ohararp/ESP32-FlipDotBinaryClock/PCB/FlipDotBinF_Panel-Netlist.TXT

ISIS SCHEMATIC DESCRIPTION FORMAT 8.0
=====================================
Design:   FlipDotBinF_Panel.pdsprj
Doc. no.: <NONE>
Revision: <NONE>
Author:   <NONE>
Created:  4/10/2016
Modified: 12/19/2025

*PROPERTIES,0    

*MODELDEFS,0    

*PARTLIST,190  
C1,"SMT ",SMT,EID=5,PACKAGE=0603
C2,"SMT ",SMT,EID=6,PACKAGE=0603
C3,SMT,AP2204-5,EID=30,PACKAGE=0603
C4,"SMT ","10 uF",EID=31,PACKAGE=1206
C5,UWT1E471MNL1GS,"470 uF 25V",BOMLINKS="CODE=http%3A%2F%2Fwww.digikey.com%2Fproduct-detail%2Fen%2Fnichicon%2FUWT1E471MNL1GS%2F493-2194-1-ND%2F590169,",CODE=647-UWT1E471MNL1S,COST=0.253,EID=F,PACKAGE=CAPAE1030X1020,SUPPLIER=Digikey
C6,UWT1E471MNL1GS,"470 uF 25V",BOMLINKS="CODE=http%3A%2F%2Fwww.digikey.com%2Fproduct-detail%2Fen%2Fnichicon%2FUWT1E471MNL1GS%2F493-2194-1-ND%2F590169,",CODE=647-UWT1E471MNL1S,COST=0.253,EID=19,PACKAGE=CAPAE1030X1020,SUPPLIER=Digikey
C7,UWT1E471MNL1GS,"470 uF 25V",BOMLINKS="CODE=http%3A%2F%2Fwww.digikey.com%2Fproduct-detail%2Fen%2Fnichicon%2FUWT1E471MNL1GS%2F493-2194-1-ND%2F590169,",CODE=647-UWT1E471MNL1S,COST=0.253,EID=23,PACKAGE=CAPAE1030X1020,SUPPLIER=Digikey
C8,UWT1E471MNL1GS,"470 uF 25V",BOMLINKS="CODE=http%3A%2F%2Fwww.digikey.com%2Fproduct-detail%2Fen%2Fnichicon%2FUWT1E471MNL1GS%2F493-2194-1-ND%2F590169,",CODE=647-UWT1E471MNL1S,COST=0.253,EID=2D,PACKAGE=CAPAE1030X1020,SUPPLIER=Digikey
C9,"SMT ",SMT,EID=34,PACKAGE=0603
C10,"SMT ",SMT,EID=35,PACKAGE=0603
C11,SMT,AP2204-5,EID=5F,PACKAGE=0603
C12,"SMT ","10 uF",EID=60,PACKAGE=1206
C13,UWT1E471MNL1GS,"470 uF 25V",BOMLINKS="CODE=http%3A%2F%2Fwww.digikey.com%2Fproduct-detail%2Fen%2Fnichicon%2FUWT1E471MNL1GS%2F493-2194-1-ND%2F590169,",CODE=647-UWT1E471MNL1S,COST=0.253,EID=3E,PACKAGE=CAPAE1030X1020,SUPPLIER=Digikey
C14,UWT1E471MNL1GS,"470 uF 25V",BOMLINKS="CODE=http%3A%2F%2Fwww.digikey.com%2Fproduct-detail%2Fen%2Fnichicon%2FUWT1E471MNL1GS%2F493-2194-1-ND%2F590169,",CODE=647-UWT1E471MNL1S,COST=0.253,EID=48,PACKAGE=CAPAE1030X1020,SUPPLIER=Digikey
C15,UWT1E471MNL1GS,"470 uF 25V",BOMLINKS="CODE=http%3A%2F%2Fwww.digikey.com%2Fproduct-detail%2Fen%2Fnichicon%2FUWT1E471MNL1GS%2F493-2194-1-ND%2F590169,",CODE=647-UWT1E471MNL1S,COST=0.253,EID=52,PACKAGE=CAPAE1030X1020,SUPPLIER=Digikey
C16,UWT1E471MNL1GS,"470 uF 25V",BOMLINKS="CODE=http%3A%2F%2Fwww.digikey.com%2Fproduct-detail%2Fen%2Fnichicon%2FUWT1E471MNL1GS%2F493-2194-1-ND%2F590169,",CODE=647-UWT1E471MNL1S,COST=0.253,EID=5C,PACKAGE=CAPAE1030X1020,SUPPLIER=Digikey
C17,"SMT ",SMT,EID=63,PACKAGE=0603
C18,"SMT ",SMT,EID=64,PACKAGE=0603
C19,SMT,AP2204-5,EID=8E,PACKAGE=0603
C20,"SMT ","10 uF",EID=8F,PACKAGE=1206
C21,UWT1E471MNL1GS,"470 uF 25V",BOMLINKS="CODE=http%3A%2F%2Fwww.digikey.com%2Fproduct-detail%2Fen%2Fnichicon%2FUWT1E471MNL1GS%2F493-2194-1-ND%2F590169,",CODE=647-UWT1E471MNL1S,COST=0.253,EID=6D,PACKAGE=CAPAE1030X1020,SUPPLIER=Digikey
C22,UWT1E471MNL1GS,"470 uF 25V",BOMLINKS="CODE=http%3A%2F%2Fwww.digikey.com%2Fproduct-detail%2Fen%2Fnichicon%2FUWT1E471MNL1GS%2F493-2194-1-ND%2F590169,",CODE=647-UWT1E471MNL1S,COST=0.253,EID=77,PACKAGE=CAPAE1030X1020,SUPPLIER=Digikey
C23,UWT1E471MNL1GS,"470 uF 25V",BOMLINKS="CODE=http%3A%2F%2Fwww.digikey.com%2Fproduct-detail%2Fen%2Fnichicon%2FUWT1E471MNL1GS%2F493-2194-1-ND%2F590169,",CODE=647-UWT1E471MNL1S,COST=0.253,EID=81,PACKAGE=CAPAE1030X1020,SUPPLIER=Digikey
C24,UWT1E471MNL1GS,"470 uF 25V",BOMLINKS="CODE=http%3A%2F%2Fwww.digikey.com%2Fproduct-detail%2Fen%2Fnichicon%2FUWT1E471MNL1GS%2F493-2194-1-ND%2F590169,",CODE=647-UWT1E471MNL1S,COST=0.253,EID=8B,PACKAGE=CAPAE1030X1020,SUPPLIER=Digikey
C25,"SMT ",SMT,EID=92,PACKAGE=0603
C26,"SMT ",SMT,EID=93,PACKAGE=0603
C27,SMT,AP2204-5,EID=BD,PACKAGE=0603
C28,"SMT ","10 uF",EID=BE,PACKAGE=1206
C29,UWT1E471MNL1GS,"470 uF 25V",BOMLINKS="CODE=http%3A%2F%2Fwww.digikey.com%2Fproduct-detail%2Fen%2Fnichicon%2FUWT1E471MNL1GS%2F493-2194-1-ND%2F590169,",CODE=647-UWT1E471MNL1S,COST=0.253,EID=9C,PACKAGE=CAPAE1030X1020,SUPPLIER=Digikey
C30,UWT1E471MNL1GS,"470 uF 25V",BOMLINKS="CODE=http%3A%2F%2Fwww.digikey.com%2Fproduct-detail%2Fen%2Fnichicon%2FUWT1E471MNL1GS%2F493-2194-1-ND%2F590169,",CODE=647-UWT1E471MNL1S,COST=0.253,EID=A6,PACKAGE=CAPAE1030X1020,SUPPLIER=Digikey
C31,UWT1E471MNL1GS,"470 uF 25V",BOMLINKS="CODE=http%3A%2F%2Fwww.digikey.com%2Fproduct-detail%2Fen%2Fnichicon%2FUWT1E471MNL1GS%2F493-2194-1-ND%2F590169,",CODE=647-UWT1E471MNL1S,COST=0.253,EID=B0,PACKAGE=CAPAE1030X1020,SUPPLIER=Digikey
C32,UWT1E471MNL1GS,"470 uF 25V",BOMLINKS="CODE=http%3A%2F%2Fwww.digikey.com%2Fproduct-detail%2Fen%2Fnichicon%2FUWT1E471MNL1GS%2F493-2194-1-ND%2F590169,",CODE=647-UWT1E471MNL1S,COST=0.253,EID=BA,PACKAGE=CAPAE1030X1020,SUPPLIER=Digikey
D1,BAV74,BAV70LT1G,EID=9,PACKAGE=SOT23,PINSWAP="2,3",SPICELIB=ZETEX,SPICEMODEL=BAV74
D2,BAV74,BAV70LT1G,EID=12,PACKAGE=SOT23,PINSWAP="2,3",SPICELIB=ZETEX,SPICEMODEL=BAV74
D3,BAV74,BAV70LT1G,EID=1D,PACKAGE=SOT23,PINSWAP="2,3",SPICELIB=ZETEX,SPICEMODEL=BAV74
D4,BAV74,BAV70LT1G,EID=27,PACKAGE=SOT23,PINSWAP="2,3",SPICELIB=ZETEX,SPICEMODEL=BAV74
D5,BAV74,BAV70LT1G,EID=38,PACKAGE=SOT23,PINSWAP="2,3",SPICELIB=ZETEX,SPICEMODEL=BAV74
D6,BAV74,BAV70LT1G,EID=41,PACKAGE=SOT23,PINSWAP="2,3",SPICELIB=ZETEX,SPICEMODEL=BAV74
D7,BAV74,BAV70LT1G,EID=4C,PACKAGE=SOT23,PINSWAP="2,3",SPICELIB=ZETEX,SPICEMODEL=BAV74
D8,BAV74,BAV70LT1G,EID=56,PACKAGE=SOT23,PINSWAP="2,3",SPICELIB=ZETEX,SPICEMODEL=BAV74
D9,BAV74,BAV70LT1G,EID=67,PACKAGE=SOT23,PINSWAP="2,3",SPICELIB=ZETEX,SPICEMODEL=BAV74
D10,BAV74,BAV70LT1G,EID=70,PACKAGE=SOT23,PINSWAP="2,3",SPICELIB=ZETEX,SPICEMODEL=BAV74
D11,BAV74,BAV70LT1G,EID=7B,PACKAGE=SOT23,PINSWAP="2,3",SPICELIB=ZETEX,SPICEMODEL=BAV74
D12,BAV74,BAV70LT1G,EID=85,PACKAGE=SOT23,PINSWAP="2,3",SPICELIB=ZETEX,SPICEMODEL=BAV74
D13,BAV74,BAV70LT1G,EID=96,PACKAGE=SOT23,PINSWAP="2,3",SPICELIB=ZETEX,SPICEMODEL=BAV74
D14,BAV74,BAV70LT1G,EID=9F,PACKAGE=SOT23,PINSWAP="2,3",SPICELIB=ZETEX,SPICEMODEL=BAV74
D15,BAV74,BAV70LT1G,EID=AA,PACKAGE=SOT23,PINSWAP="2,3",SPICELIB=ZETEX,SPICEMODEL=BAV74
D16,BAV74,BAV70LT1G,EID=B4,PACKAGE=SOT23,PINSWAP="2,3",SPICELIB=ZETEX,SPICEMODEL=BAV74
FP1,FLIPDOT-1872R,FLIPDOT-1872R,CODE=1872RFR,EID=A,PACKAGE=FLIPDOT-1872R
FP2,FLIPDOT-1872R,FLIPDOT-1872R,CODE=1872RFR,EID=14,PACKAGE=FLIPDOT-1872R
FP3,FLIPDOT-1872R,FLIPDOT-1872R,CODE=1872RFR,EID=1E,PACKAGE=FLIPDOT-1872R
FP4,FLIPDOT-1872R,FLIPDOT-1872R,CODE=1872RFR,EID=28,PACKAGE=FLIPDOT-1872R
FP5,FLIPDOT-1872R,FLIPDOT-1872R,CODE=1872RFR,EID=39,PACKAGE=FLIPDOT-1872R
FP6,FLIPDOT-1872R,FLIPDOT-1872R,CODE=1872RFR,EID=43,PACKAGE=FLIPDOT-1872R
FP7,FLIPDOT-1872R,FLIPDOT-1872R,CODE=1872RFR,EID=4D,PACKAGE=FLIPDOT-1872R
FP8,FLIPDOT-1872R,FLIPDOT-1872R,CODE=1872RFR,EID=57,PACKAGE=FLIPDOT-1872R
FP9,FLIPDOT-1872R,FLIPDOT-1872R,CODE=1872RFR,EID=68,PACKAGE=FLIPDOT-1872R
FP10,FLIPDOT-1872R,FLIPDOT-1872R,CODE=1872RFR,EID=72,PACKAGE=FLIPDOT-1872R
FP11,FLIPDOT-1872R,FLIPDOT-1872R,CODE=1872RFR,EID=7C,PACKAGE=FLIPDOT-1872R
FP12,FLIPDOT-1872R,FLIPDOT-1872R,CODE=1872RFR,EID=86,PACKAGE=FLIPDOT-1872R
FP13,FLIPDOT-1872R,FLIPDOT-1872R,CODE=1872RFR,EID=97,PACKAGE=FLIPDOT-1872R
FP14,FLIPDOT-1872R,FLIPDOT-1872R,CODE=1872RFR,EID=A1,PACKAGE=FLIPDOT-1872R
FP15,FLIPDOT-1872R,FLIPDOT-1872R,CODE=1872RFR,EID=AB,PACKAGE=FLIPDOT-1872R
FP16,FLIPDOT-1872R,FLIPDOT-1872R,CODE=1872RFR,EID=B5,PACKAGE=FLIPDOT-1872R
G1-DATA IN,GROVE_SER,"GROVE I2C",CODE=1125s-SMT-4P,EID=2,PACKAGE=1125S-SMT-4P-HORZ
G2-PWR,GROVE_SER,"GROVE I2C",CODE=1125s-SMT-4P,EID=3,PACKAGE=1125S-SMT-4P-HORZ
Q1,DMG3402L,DMG3402L,CODE=DMG3402L-7DICT-ND,EID=8,PACKAGE=SOT23-3,SPICEPINS="D,G,S"
Q2,DMG3402L,DMG3402L,CODE=DMG3402L-7DICT-ND,EID=C,PACKAGE=SOT23-3,SPICEPINS="D,G,S"
Q3,DMG6602SVT-2,DMG6602SVT-2,EID=D,PACKAGE=TSOP-6-FIX
Q4,DMG3402L,DMG3402L,CODE=DMG3402L-7DICT-ND,EID=11,PACKAGE=SOT23-3,SPICEPINS="D,G,S"
Q5,DMG3402L,DMG3402L,CODE=DMG3402L-7DICT-ND,EID=16,PACKAGE=SOT23-3,SPICEPINS="D,G,S"
Q6,DMG6602SVT-2,DMG6602SVT-2,EID=17,PACKAGE=TSOP-6-FIX
Q7,DMG3402L,DMG3402L,CODE=DMG3402L-7DICT-ND,EID=1C,PACKAGE=SOT23-3,SPICEPINS="D,G,S"
Q8,DMG3402L,DMG3402L,CODE=DMG3402L-7DICT-ND,EID=20,PACKAGE=SOT23-3,SPICEPINS="D,G,S"
Q9,DMG6602SVT-2,DMG6602SVT-2,EID=21,PACKAGE=TSOP-6-FIX
Q10,DMG3402L,DMG3402L,CODE=DMG3402L-7DICT-ND,EID=26,PACKAGE=SOT23-3,SPICEPINS="D,G,S"
Q11,DMG3402L,DMG3402L,CODE=DMG3402L-7DICT-ND,EID=2A,PACKAGE=SOT23-3,SPICEPINS="D,G,S"
Q12,DMG6602SVT-2,DMG6602SVT-2,EID=2B,PACKAGE=TSOP-6-FIX
Q13,DMG3402L,DMG3402L,CODE=DMG3402L-7DICT-ND,EID=37,PACKAGE=SOT23-3,SPICEPINS="D,G,S"
Q14,DMG3402L,DMG3402L,CODE=DMG3402L-7DICT-ND,EID=3B,PACKAGE=SOT23-3,SPICEPINS="D,G,S"
Q15,DMG6602SVT-2,DMG6602SVT-2,EID=3C,PACKAGE=TSOP-6-FIX
Q16,DMG3402L,DMG3402L,CODE=DMG3402L-7DICT-ND,EID=40,PACKAGE=SOT23-3,SPICEPINS="D,G,S"
Q17,DMG3402L,DMG3402L,CODE=DMG3402L-7DICT-ND,EID=45,PACKAGE=SOT23-3,SPICEPINS="D,G,S"
Q18,DMG6602SVT-2,DMG6602SVT-2,EID=46,PACKAGE=TSOP-6-FIX
Q19,DMG3402L,DMG3402L,CODE=DMG3402L-7DICT-ND,EID=4B,PACKAGE=SOT23-3,SPICEPINS="D,G,S"
Q20,DMG3402L,DMG3402L,CODE=DMG3402L-7DICT-ND,EID=4F,PACKAGE=SOT23-3,SPICEPINS="D,G,S"
Q21,DMG6602SVT-2,DMG6602SVT-2,EID=50,PACKAGE=TSOP-6-FIX
Q22,DMG3402L,DMG3402L,CODE=DMG3402L-7DICT-ND,EID=55,PACKAGE=SOT23-3,SPICEPINS="D,G,S"
Q23,DMG3402L,DMG3402L,CODE=DMG3402L-7DICT-ND,EID=59,PACKAGE=SOT23-3,SPICEPINS="D,G,S"
Q24,DMG6602SVT-2,DMG6602SVT-2,EID=5A,PACKAGE=TSOP-6-FIX
Q25,DMG3402L,DMG3402L,CODE=DMG3402L-7DICT-ND,EID=66,PACKAGE=SOT23-3,SPICEPINS="D,G,S"
Q26,DMG3402L,DMG3402L,CODE=DMG3402L-7DICT-ND,EID=6A,PACKAGE=SOT23-3,SPICEPINS="D,G,S"
Q27,DMG6602SVT-2,DMG6602SVT-2,EID=6B,PACKAGE=TSOP-6-FIX
Q28,DMG3402L,DMG3402L,CODE=DMG3402L-7DICT-ND,EID=6F,PACKAGE=SOT23-3,SPICEPINS="D,G,S"
Q29,DMG3402L,DMG3402L,CODE=DMG3402L-7DICT-ND,EID=74,PACKAGE=SOT23-3,SPICEPINS="D,G,S"
Q30,DMG6602SVT-2,DMG6602SVT-2,EID=75,PACKAGE=TSOP-6-FIX
Q31,DMG3402L,DMG3402L,CODE=DMG3402L-7DICT-ND,EID=7A,PACKAGE=SOT23-3,SPICEPINS="D,G,S"
Q32,DMG3402L,DMG3402L,CODE=DMG3402L-7DICT-ND,EID=7E,PACKAGE=SOT23-3,SPICEPINS="D,G,S"
Q33,DMG6602SVT-2,DMG6602SVT-2,EID=7F,PACKAGE=TSOP-6-FIX
Q34,DMG3402L,DMG3402L,CODE=DMG3402L-7DICT-ND,EID=84,PACKAGE=SOT23-3,SPICEPINS="D,G,S"
Q35,DMG3402L,DMG3402L,CODE=DMG3402L-7DICT-ND,EID=88,PACKAGE=SOT23-3,SPICEPINS="D,G,S"
Q36,DMG6602SVT-2,DMG6602SVT-2,EID=89,PACKAGE=TSOP-6-FIX
Q37,DMG3402L,DMG3402L,CODE=DMG3402L-7DICT-ND,EID=95,PACKAGE=SOT23-3,SPICEPINS="D,G,S"
Q38,DMG3402L,DMG3402L,CODE=DMG3402L-7DICT-ND,EID=99,PACKAGE=SOT23-3,SPICEPINS="D,G,S"
Q39,DMG6602SVT-2,DMG6602SVT-2,EID=9A,PACKAGE=TSOP-6-FIX
Q40,DMG3402L,DMG3402L,CODE=DMG3402L-7DICT-ND,EID=9E,PACKAGE=SOT23-3,SPICEPINS="D,G,S"
Q41,DMG3402L,DMG3402L,CODE=DMG3402L-7DICT-ND,EID=A3,PACKAGE=SOT23-3,SPICEPINS="D,G,S"
Q42,DMG6602SVT-2,DMG6602SVT-2,EID=A4,PACKAGE=TSOP-6-FIX
Q43,DMG3402L,DMG3402L,CODE=DMG3402L-7DICT-ND,EID=A9,PACKAGE=SOT23-3,SPICEPINS="D,G,S"
Q44,DMG3402L,DMG3402L,CODE=DMG3402L-7DICT-ND,EID=AD,PACKAGE=SOT23-3,SPICEPINS="D,G,S"
Q45,DMG6602SVT-2,DMG6602SVT-2,EID=AE,PACKAGE=TSOP-6-FIX
Q46,DMG3402L,DMG3402L,CODE=DMG3402L-7DICT-ND,EID=B3,PACKAGE=SOT23-3,SPICEPINS="D,G,S"
Q47,DMG3402L,DMG3402L,CODE=DMG3402L-7DICT-ND,EID=B7,PACKAGE=SOT23-3,SPICEPINS="D,G,S"
Q48,DMG6602SVT-2,DMG6602SVT-2,EID=B8,PACKAGE=TSOP-6-FIX
R1,RES,22k,EID=7,PACKAGE=0603,PRIMTYPE=RESISTOR
R2,RES,22k,EID=B,PACKAGE=0603,PRIMTYPE=RESISTOR
R3,RES,22k,EID=E,PACKAGE=0603,PRIMTYPE=RESISTOR
R4,RES,22k,EID=13,PACKAGE=0603,PRIMTYPE=RESISTOR
R5,RES,22k,EID=10,PACKAGE=0603,PRIMTYPE=RESISTOR
R6,RES,22k,EID=15,PACKAGE=0603,PRIMTYPE=RESISTOR
R7,RES,22k,EID=18,PACKAGE=0603,PRIMTYPE=RESISTOR
R8,RES,22k,EID=1A,PACKAGE=0603,PRIMTYPE=RESISTOR
R9,RES,22k,EID=1B,PACKAGE=0603,PRIMTYPE=RESISTOR
R10,RES,22k,EID=1F,PACKAGE=0603,PRIMTYPE=RESISTOR
R11,RES,22k,EID=22,PACKAGE=0603,PRIMTYPE=RESISTOR
R12,RES,22k,EID=24,PACKAGE=0603,PRIMTYPE=RESISTOR
R13,RES,22k,EID=25,PACKAGE=0603,PRIMTYPE=RESISTOR
R14,RES,22k,EID=29,PACKAGE=0603,PRIMTYPE=RESISTOR
R15,RES,22k,EID=2C,PACKAGE=0603,PRIMTYPE=RESISTOR
R16,RES,22k,EID=2E,PACKAGE=0603,PRIMTYPE=RESISTOR
R17,RES,22k,EID=36,PACKAGE=0603,PRIMTYPE=RESISTOR
R18,RES,22k,EID=3A,PACKAGE=0603,PRIMTYPE=RESISTOR
R19,RES,22k,EID=3D,PACKAGE=0603,PRIMTYPE=RESISTOR
R20,RES,22k,EID=42,PACKAGE=0603,PRIMTYPE=RESISTOR
R21,RES,22k,EID=3F,PACKAGE=0603,PRIMTYPE=RESISTOR
R22,RES,22k,EID=44,PACKAGE=0603,PRIMTYPE=RESISTOR
R23,RES,22k,EID=47,PACKAGE=0603,PRIMTYPE=RESISTOR
R24,RES,22k,EID=49,PACKAGE=0603,PRIMTYPE=RESISTOR
R25,RES,22k,EID=4A,PACKAGE=0603,PRIMTYPE=RESISTOR
R26,RES,22k,EID=4E,PACKAGE=0603,PRIMTYPE=RESISTOR
R27,RES,22k,EID=51,PACKAGE=0603,PRIMTYPE=RESISTOR
R28,RES,22k,EID=53,PACKAGE=0603,PRIMTYPE=RESISTOR
R29,RES,22k,EID=54,PACKAGE=0603,PRIMTYPE=RESISTOR
R30,RES,22k,EID=58,PACKAGE=0603,PRIMTYPE=RESISTOR
R31,RES,22k,EID=5B,PACKAGE=0603,PRIMTYPE=RESISTOR
R32,RES,22k,EID=5D,PACKAGE=0603,PRIMTYPE=RESISTOR
R33,RES,22k,EID=65,PACKAGE=0603,PRIMTYPE=RESISTOR
R34,RES,22k,EID=69,PACKAGE=0603,PRIMTYPE=RESISTOR
R35,RES,22k,EID=6C,PACKAGE=0603,PRIMTYPE=RESISTOR
R36,RES,22k,EID=71,PACKAGE=0603,PRIMTYPE=RESISTOR
R37,RES,22k,EID=6E,PACKAGE=0603,PRIMTYPE=RESISTOR
R38,RES,22k,EID=73,PACKAGE=0603,PRIMTYPE=RESISTOR
R39,RES,22k,EID=76,PACKAGE=0603,PRIMTYPE=RESISTOR
R40,RES,22k,EID=78,PACKAGE=0603,PRIMTYPE=RESISTOR
R41,RES,22k,EID=79,PACKAGE=0603,PRIMTYPE=RESISTOR
R42,RES,22k,EID=7D,PACKAGE=0603,PRIMTYPE=RESISTOR
R43,RES,22k,EID=80,PACKAGE=0603,PRIMTYPE=RESISTOR
R44,RES,22k,EID=82,PACKAGE=0603,PRIMTYPE=RESISTOR
R45,RES,22k,EID=83,PACKAGE=0603,PRIMTYPE=RESISTOR
R46,RES,22k,EID=87,PACKAGE=0603,PRIMTYPE=RESISTOR
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
R15,PS,1
Q12,PS,5
Q11,PS,3
R14,PS,1
Q10,PS,3
R13,PS,1
C8,PS,2
R11,PS,1
Q9,PS,5
Q8,PS,3
R10,PS,1
Q7,PS,3
R9,PS,1
C7,PS,2
R7,PS,1
Q6,PS,5
Q5,PS,3
R6,PS,1
Q4,PS,3
R5,PS,1
C6,PS,2
R3,PS,1
Q3,PS,5
Q2,PS,3
R2,PS,1
Q1,PS,3
R1,PS,1
C5,PS,2
C2,PS,2
C1,PS,2
U2,PP,8
U1,PP,8
G2-PWR,PP,4
G1-DATA IN,PP,4

HV,62,CLASS=POWER
HV,PR
U12,PS,1
U12,PS,3
C28,PS,2
Q48,PS,2
R64,PS,2
C32,PS,1
Q45,PS,2
R60,PS,2
C31,PS,1
Q42,PS,2
R56,PS,2
C30,PS,1
Q39,PS,2
R52,PS,2
C29,PS,1
U9,PS,1
U9,PS,3
C20,PS,2
Q36,PS,2
R48,PS,2
C24,PS,1
Q33,PS,2
R44,PS,2
C23,PS,1
Q30,PS,2
R40,PS,2
C22,PS,1
Q27,PS,2
R36,PS,2
C21,PS,1
U6,PS,1
U6,PS,3
C12,PS,2
Q24,PS,2
R32,PS,2
C16,PS,1
Q21,PS,2
R28,PS,2
C15,PS,1
Q18,PS,2
R24,PS,2
C14,PS,1
Q15,PS,2
R20,PS,2
C13,PS,1
U3,PS,1
U3,PS,3
C4,PS,2
Q12,PS,2
R16,PS,2
C8,PS,1
Q9,PS,2
R12,PS,2
C7,PS,1
Q6,PS,2
R8,PS,2
C6,PS,1
Q3,PS,2
R4,PS,2
C5,PS,1
G2-PWR,PP,3
