ohararp/ESP32-FlipDotBinaryClock/PCB/FlipDotMasterC-netlist.TXT

ISIS SCHEMATIC DESCRIPTION FORMAT 8.0
=====================================
Design:   FlipDotMasterC.pdsprj
Doc. no.: <NONE>
Revision: <NONE>
Author:   <NONE>
Created:  5/20/2017
Modified: 1/6/2018

*PROPERTIES,0    

*MODELDEFS,0    

*PARTLIST,32   
B1-RESET,PTS810,PTS810,CODE=CKN10503TR-ND,COST=0.58,EID=36,PACKAGE=PTS810,R(0)=100M,R(1)=100m,STATE=0,SUPPLIER=Digikey,TSWITCH=1m
B2-HRS,PTS810,PTS810,CODE=CKN10503TR-ND,COST=0.58,EID=9,PACKAGE=PTS810,R(0)=100M,R(1)=100m,STATE=0,SUPPLIER=Digikey,TSWITCH=1m
B3-MINS,PTS810,PTS810,CODE=CKN10503TR-ND,COST=0.58,EID=C,PACKAGE=PTS810,R(0)=100M,R(1)=100m,STATE=0,SUPPLIER=Digikey,TSWITCH=1m
BAT1,S8411-45R,3.3V,BOMLINKS="CODE=http%3A%2F%2Fwww.digikey.com%2Fproduct-detail%2Fen%2FS8411-45R%2F952-1745-1-ND%2F3131073,",CODE="952-1745-1-ND ",COST=1.08,EID=4,PACKAGE=S8411-45R,SUPPLIER=Digikey
BST1,XL6009BRD2,XL6009BRD2,COST=2.86,EID=10,PACKAGE=XL6009BRD2,SUPPLIER=Alibaba
C1,"SMT ","10 uF",EID=F,PACKAGE=1206
C2,"SMT ","10 uF",EID=E,PACKAGE=0603
C3,"SMT ",0.1UF,EID=3C,PACKAGE=0603
C4,"SMT ",0.1UF,EID=3B,PACKAGE=0603
C5,"SMT ",0.1UF,EID=23,PACKAGE=0603
C6,"SMT ",0.1UF,EID=7,PACKAGE=0603
C7,UWT1E471MNL1GS,"470 uF 25V",BOMLINKS="CODE=http%3A%2F%2Fwww.digikey.com%2Fproduct-detail%2Fen%2Fnichicon%2FUWT1E471MNL1GS%2F493-2194-1-ND%2F590169,",CODE=647-UWT1E471MNL1S,COST=0.253,EID=22,PACKAGE=CAPAE1030X1020,SUPPLIER=Digikey
C8,UWT1E471MNL1GS,"470 uF 25V",BOMLINKS="CODE=http%3A%2F%2Fwww.digikey.com%2Fproduct-detail%2Fen%2Fnichicon%2FUWT1E471MNL1GS%2F493-2194-1-ND%2F590169,",CODE=647-UWT1E471MNL1S,COST=0.253,EID=24,PACKAGE=CAPAE1030X1020,SUPPLIER=Digikey
C9,UWT1E471MNL1GS,"470 uF 25V",BOMLINKS="CODE=http%3A%2F%2Fwww.digikey.com%2Fproduct-detail%2Fen%2Fnichicon%2FUWT1E471MNL1GS%2F493-2194-1-ND%2F590169,",CODE=647-UWT1E471MNL1S,COST=0.253,EID=25,PACKAGE=CAPAE1030X1020,SUPPLIER=Digikey
C10,UWT1E471MNL1GS,"470 uF 25V",BOMLINKS="CODE=http%3A%2F%2Fwww.digikey.com%2Fproduct-detail%2Fen%2Fnichicon%2FUWT1E471MNL1GS%2F493-2194-1-ND%2F590169,",CODE=647-UWT1E471MNL1S,COST=0.253,EID=26,PACKAGE=CAPAE1030X1020,SUPPLIER=Digikey
D4,LED,,BV=4V,CJO=10p,EID=2A,IS=1E-38,N=1,PACKAGE=0603-LED,RS=3
G1-DATA OUT,GROVE_SER,"GROVE SER",CODE=1125s-SMT-4P,EID=A,PACKAGE=1125S-SMT-4P-HORZ
G2-HV OUT,GROVE_SER,"GROVE PWR",CODE=1125s-SMT-4P,EID=16,PACKAGE=1125S-SMT-4P-HORZ
J1-5V,PJ-102A,PJ-102A,BOMLINKS="CODE=http%3A%2F%2Fwww.digikey.com%2Fproduct-detail%2Fen%2FPJ-102A%2FCP-102A-ND%2F275425,",CODE=CP-102A-ND,COST=1.0,EID=1,PACKAGE=PJ-102AB,SUPPLIER=Digikey
J2,CONN-DIL6,CONN-DIL6,EID=20,PACKAGE=CONN-DIL6
J6-FTDI,FTDI_CABLE,FTDI_CABLE,CODE=768-1015-ND,COST=0.074,EID=3A,LINK=http://www.digikey.com/product-detail/en/TTL-232R-3V3/768-1015-ND/1836393,PACKAGE="FTDI CABLE",PARTID=HWS2382,SUPPLIER=Digikey
R1,RES,4k7,BOMLINKS="CODE=http%3A%2F%2Fwww.digikey.com%2Fproduct-detail%2Fen%2FRC1206JR-074K7L%2F311-4.7KERCT-ND%2F732242,",CODE=311-4.7KERTR-ND,COST=0.00289,EID=5,PACKAGE=0603,PRIMTYPE=RESISTOR,SUPPLIER=Digikey
R2,RES,4k7,BOMLINKS="CODE=http%3A%2F%2Fwww.digikey.com%2Fproduct-detail%2Fen%2FRC1206JR-074K7L%2F311-4.7KERCT-ND%2F732242,",CODE=311-4.7KERTR-ND,COST=0.00289,EID=6,PACKAGE=0603,PRIMTYPE=RESISTOR,SUPPLIER=Digikey
R3,RES,4k7,BOMLINKS="CODE=http%3A%2F%2Fwww.digikey.com%2Fproduct-detail%2Fen%2FRC1206JR-074K7L%2F311-4.7KERCT-ND%2F732242,",CODE=311-4.7KERTR-ND,COST=0.00289,EID=18,PACKAGE=0603,PRIMTYPE=RESISTOR,SUPPLIER=Digikey
R4,MINRES10K,10k,EID=1E,PACKAGE=0603,PRIMTYPE=RESISTOR
R5,MINRES10K,10k,EID=8,PACKAGE=0603,PRIMTYPE=RESISTOR
R6,MINRES10K,10k,EID=B,PACKAGE=0603,PRIMTYPE=RESISTOR
R9,MINRES330R,330R,CODE=311-330GTR-ND,EID=29,PACKAGE=0603,PRIMTYPE=RESISTOR,SUPPLIER=Digikey
U1,AP2204-33,AP2204-33,BOMLINKS="CODE=http%3A%2F%2Fwww.digikey.com%2Fproduct-detail%2Fen%2Fdiodes-incorporated%2FAP2204K-3.3TRG1%2FAP2204K-3.3TRG1DICT-ND%2F4505288,",CODE=AP2204K-3.3TRG1,COST=0.45,EID=D,PACKAGE=SOT23-5,SUPPLIER=Digikey
U3,ATMEGA328P_32PIN,ATMEGA328P_32PIN,BOMLINKS="CODE=http%3A%2F%2Fwww.digikey.com%2Fproduct-search%2Fen%3Fkeywords%3DATMEGA328P-AURCT-ND,",BOOTRST=1,BOOTSZ=0,CKOUT=1,CKSEL=2,CLKDIV8=0,CODE=ATMEGA328P-AURCT-ND,CODEGEN=AVRASM2,COST=3.7,DISASM_BIN=0,EID=39,ITFMOD=AVR,MODDATA="1024,255",MODDLL=AVR2.DLL,PACKAGE=QFP80P900X900X120-32,RSTDISBL=1,SUPPLIER=Digikey,SUT=2,TRACE_DEFAULT=1,WDTON=1
U4,DS3231,DS3231,BOMLINKS="CODE=http%3A%2F%2Fwww.digikey.com%2Fproduct-detail%2Fen%2FDS3231S%2523%2FDS3231S%2523-ND%2F1197574,",CODE=DS3231S#-ND,COST=8.35,EID=17,PACKAGE=SO16W
X1,CSTC08M0V53-R0,CSTCE8M00G55Z-R0,BOMLINKS="CODE=http%3A%2F%2Fwww.digikey.com%2Fproduct-detail%2Fen%2Fmurata-electronics-north-america%2FCSTCE8M00G55Z-R0%2F490-1219-1-ND%2F584647,",CODE=490-1219-1-ND,COST=0.48,EID=3D,PACKAGE=CSTCE16M0V53-R0,SUPPLIER=Digikey

*NETLIST,38   
#00004,2
R9,PS,2
D4,PS,2

#00023,2
U3,IO,8
X1,PS,3

#00024,2
U3,IO,7
X1,PS,1

#00033,2
U3,PS,20
C4,PS,2

#00051,2
BAT1,PP,1
U4,PS,14

#00079,1
J1-5V,PS,3

#00092,1
U1,PS,4

#00095,1
U4,IO,4

#00097,1
U4,OP,1

D8,2
D8,GT
U3,IO,12

D9,2
D9,GT
U3,IO,13

D6,2
D6,GT
U3,IO,10

D5,3
LED,LBL
D5,GT
U3,IO,9

A3,2
A3,GT
U3,IO,26

A2,2
A2,GT
U3,PS,25

A1,2
A1,GT
U3,IO,24

A0,2
A0,GT
U3,IO,23

D7,3
SUPPLY,LBL
D7,GT
U3,IO,11

A6,2
A6,GT
U3,PS,19

A7,2
A7,GT
U3,PS,22

RXI,3
RXI,GT
J6-FTDI,PS,4
U3,IO,30

TXO,3
TXO,GT
J6-FTDI,PS,5
U3,IO,31

DTR,3
DTR,GT
C5,PS,1
J6-FTDI,PS,6

MISO,4
MISO,GT
D12,GT
J2,PS,1
U3,IO,16

RESET,7
RESET,GT
J2,PS,3
U3,IO,29
R4,PS,1
B1-RESET,PS,1
B1-RESET,PS,2
C5,PS,2

SDA,5
SDA,GT
A4,GT
R1,PS,2
U4,IO,15
U3,IO,27

SCL,5
SCL,GT
A5,GT
R2,PS,2
U4,IO,16
U3,IO,28

HRS,6
HRS,GT
D3,GT
R5,PS,1
B2-HRS,PS,1
B2-HRS,PS,2
U3,IO,1

MINS,6
MINS,GT
D4,GT
R6,PS,1
B3-MINS,PS,1
B3-MINS,PS,2
U3,IO,2

SCK,6
SCK,IT
D13,GT
G1-DATA OUT,PS,1
J2,PS,2
U3,IO,17
D4,PS,1

MOSI,5
MOSI,IT
D11,GT
G1-DATA OUT,PS,2
J2,PS,5
U3,IO,15

SS,4
SS,IT
D10,GT
G1-DATA OUT,PP,3
U3,IO,14

SQW,5
SQW,GT
D2,GT
U4,OP,3
R3,PS,2
U3,PS,32

{NC},14
U4,PS,5
U4,PS,6
U4,PS,7
U4,PS,8
U4,PS,9
U4,PS,10
U4,PS,11
U4,PS,12
G2-HV OUT,PS,5
G2-HV OUT,PS,6
G1-DATA OUT,PS,5
G1-DATA OUT,PS,6
BAT1,PS,3
BAT1,PS,4

3.3V,18,CLASS=POWER
3.3V,PR
U1,TS,5
C2,PS,2
R3,PS,1
G2-HV OUT,PS,1
R6,PS,2
R5,PS,2
U4,PP,2
C6,PS,2
R2,PS,1
R1,PS,1
J2,PS,6
J6-FTDI,PS,3
U3,IP,18
U3,PP,4
U3,PP,6
C3,PS,2
R4,PS,2

5V,6,CLASS=POWER
5V,PR
BST1,PP,1
J1-5V,PS,1
U1,PS,1
U1,PS,3
C1,PS,2

GND,32,CLASS=POWER
GND,PR
U4,PP,13
C2,PS,1
U1,PS,2
C1,PS,1
C10,PS,2
C9,PS,2
C8,PS,2
C7,PS,2
BST1,PP,2
BST1,PP,3
J1-5V,PS,2
G2-HV OUT,PP,4
G1-DATA OUT,PP,4
B3-MINS,PS,3
B3-MINS,PS,4
B2-HRS,PS,3
B2-HRS,PS,4
C6,PS,1
BAT1,PP,2
J2,PS,4
C3,PS,1
C4,PS,1
J6-FTDI,PS,1
J6-FTDI,PS,2
U3,PP,3
U3,PP,5
U3,PP,21
X1,PS,2
R9,PS,1
B1-RESET,PS,3
B1-RESET,PS,4

HV,8,CLASS=POWER
HV,PR
C10,PS,1
C9,PS,1
C8,PS,1
C7,PS,1
BST1,PP,4
G2-HV OUT,PS,2
G2-HV OUT,PP,3
