ohararp/ESP32-FlipDotBinaryClock/PCB/FlipDotMasterC.PDF

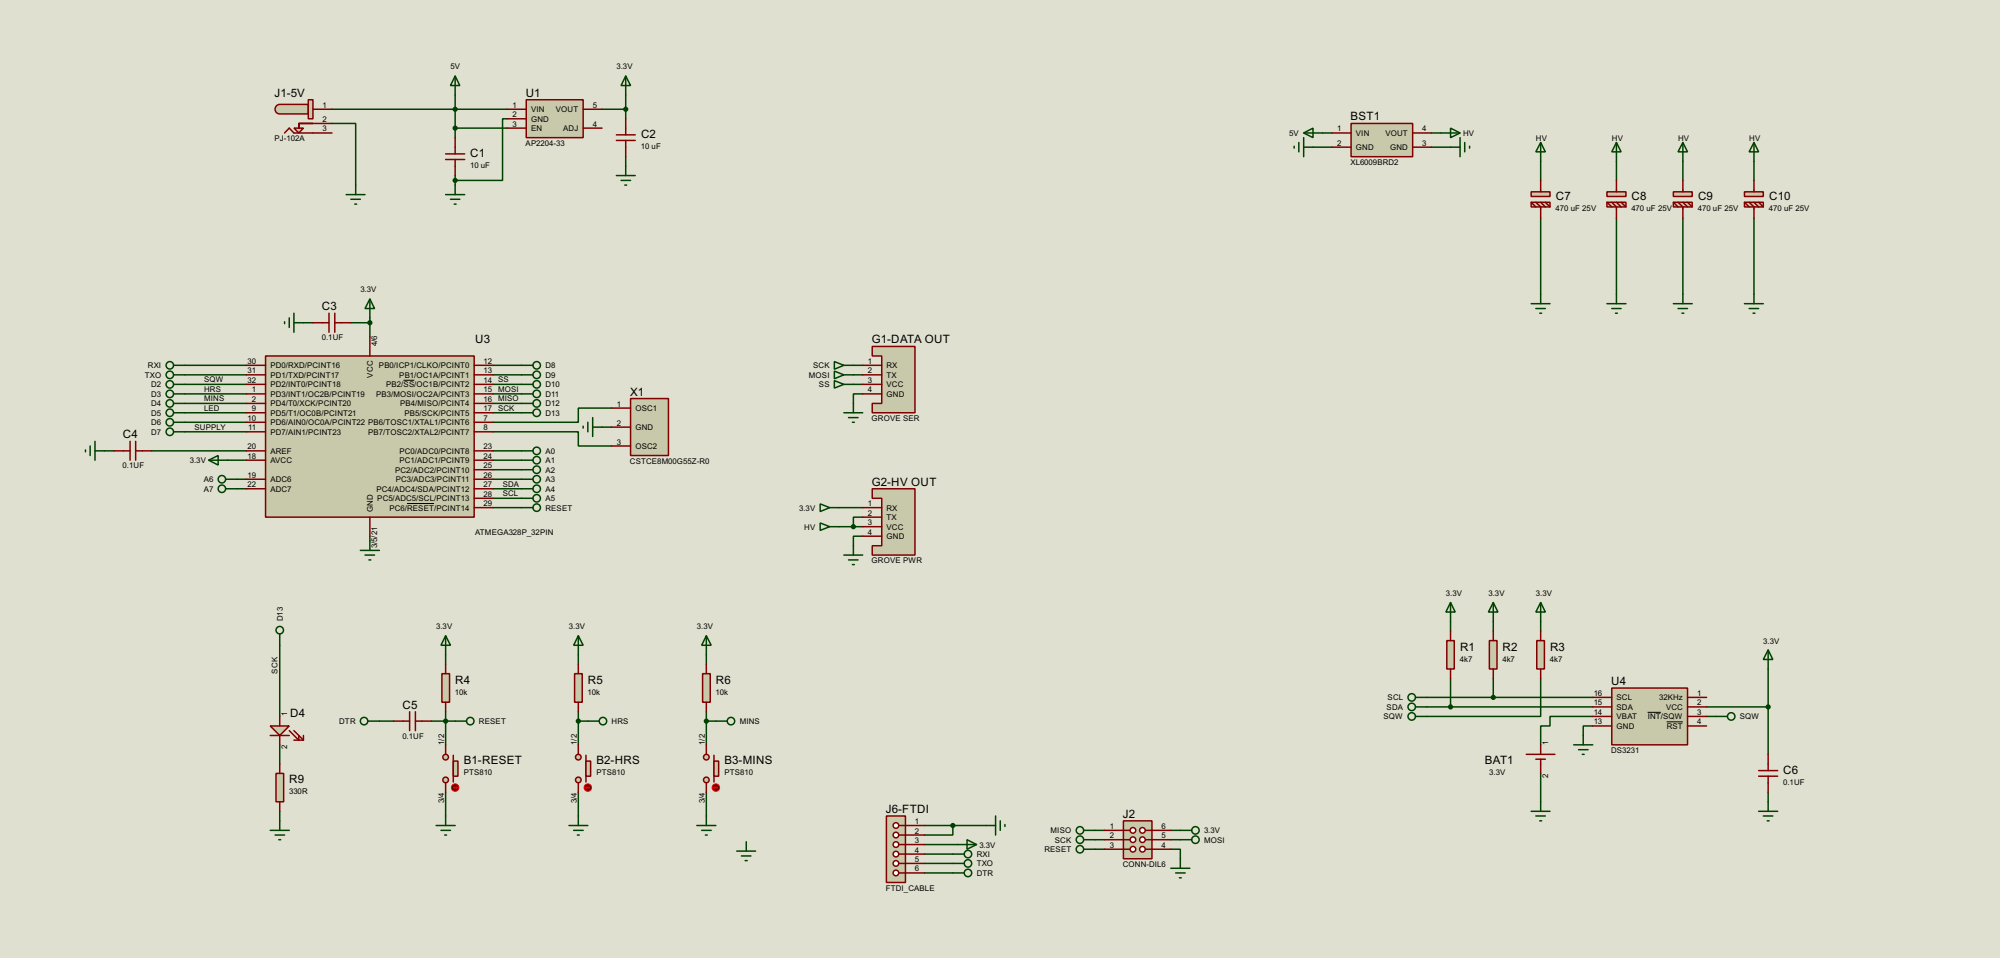
[picture p1: page 1]
