ohararp/ESP32-FlipDotBinaryClock/(list of files, drawings)

Other design files:
PCB/FlipDotBinF_Panel.pdsprj
PCB/FlipDotMasterC.pdsprj
