ohararp/ESP32-FlipDotBinaryClock/(commit log)

2026-02-09 Getting started
    Initial commit with CircuitPython binary clock code adapted from circle clock.
    [FlipDotBinF_Panel.pdsprj, FlipDotMasterC.pdsprj]
2026-02-09 Fix column order and add debug animation
    - Fixed webpage column display order to match hardware
    - Added debug animation (1-8 count per column) for troubleshooting
    - Added Debug 1-8 button to web interface
    [code-binaryclock.py]
2026-02-09 Fix minute update to always force all dots
    Changed from XOR differential update to always use flagXOR=1
    for reliable dot flipping on automatic minute changes.
    [code-binaryclock.py]
2026-02-09 Add comprehensive README with hardware documentation
    Documents the 4x4 BCD flipdot display architecture including:
    - Shift register chain (8x 74HC4094)
    - Per-dot control signals (SUPPLY, SET, RESET)
    - Bit mapping for columns and rows
    - ESP32 pin assignments
    - Web API endpoints
    - Installation instructions
2026-02-10 Move relay pin initialization to module level
    Initialize flipdot relay pin inline at module load rather than
    via setupFlipdotPower() function call during startup sequence.
    [code-binaryclock.py]
2026-02-13 Clear shift registers at startup to ensure supply bits are off
    Shifts 64 bits of zeros through all 8 daisy-chained 74HC4094 registers
    immediately after GPIO initialization, before any other setup code runs.
2026-02-13 Add boot.py for earliest shift register clearing
    - boot.py runs before code.py to clear shift registers immediately at boot
    - Removes duplicate clearing code from code.py (boot.py handles it)
    - Adds comment explaining why pin init is in both files (separate Python sessions)
2026-03-01 Add FeatherS3 and CircuitPython 10.0.3 documentation
    - Update README to reference Unexpected Maker FeatherS3 board
    - Add lib/ folder with README listing required CircuitPython libraries
    - Fix installation instructions with correct library dependencies
    - Update code comments in boot.py and code-binaryclock.py
    [boot.py, code-binaryclock.py]
2026-03-01 Add CircuitPython 10.x library files
    Include pre-compiled .mpy libraries from Adafruit bundle:
    - adafruit_ds3231 (RTC)
    - adafruit_dotstar (LED)
    - adafruit_displayio_sh1107 (OLED)
    - adafruit_display_text (text rendering)
    - adafruit_display_shapes (shapes)
    - adafruit_httpserver (web server)
    - adafruit_requests (HTTP client)
    - adafruit_ntp (time sync)
    - adafruit_connection_manager (connection pooling)
2026-03-01 Fix FeatherS3 compatibility issues
    - Use NeoPixel instead of DotStar for onboard RGB LED
    - Enable NEOPIXEL_POWER pin for FeatherS3
    - Use default board.I2C() for OLED/RTC (not custom IO3/IO4)
    - Add busio import for future flexibility
    [code-binaryclock.py]
2026-03-01 Fix I2C pin documentation in README
    Correct OLED/RTC pins to FeatherS3 default I2C (IO8/IO9)
2026-03-01 Improve relay pin handling during boot
    - Keep relay pin configured in boot.py to prevent floating
    - Handle already-configured pin in code.py
    - Add comments about GPIO11 strapping pin behavior
    - Note: Hardware requires 4.7K pull-down on IO11 to overcome
    internal pull-up during ESP32-S3 boot sequence
    [boot.py, code-binaryclock.py]
2026-03-01 Document IO11 pull-down resistor requirement
    GPIO11 is a strapping pin with internal pull-up during boot.
    4.7K pull-down required for active-high relay circuits.
2026-03-01 Add web-configurable animation speed
    Animations now use a global anim_frame_delay (default 0.5s) that can be
    adjusted via /anim/speed GET/POST endpoints. Speed is clamped to 0.1-5.0s.
2026-03-01 Add animation speed controls to web interface
    Slider control (0.1-2.0s) in Animations card with Apply button.
    Speed syncs from device status on page load.
